aks3g/AiModelCar/README.md

# AiModelCar
A platform for AI Model Car.
