aks3g/AiModelCar/src/samples/with_odometer/readme.txt

■サンプル名：
with_odometer

■サンプル概要：
走行距離計から得られる情報を処理するプログラムです

■サンプル説明：
別添えの走行距離計から得られる走行距離情報もMicro SDカードに保存します。
表現形式は16進数のCSVです。

時刻情報,走行距離,制御値,加速度X,加速度Y,加速度Z,角速度X,角速度Y,角速度Z

の並びで保存されます。

■実行方法
1．プログラムを制御基板に書き込む
2．電源を入れる
3. SW1 を押して制御を開始する

■注意点：
Micro SDカードへの書込処理中に電源を落とさないようにしてください。
SW1を押下後、走行中はMicro SDカードへの書き込みが断続的に発生します。再度SW1を押下してモータの回転を止めると書込み動作が止まる為安全に電源を切る事が可能です。

■ETC.
Witten by Akasaka
