aks3g/AiModelCar/src/AtmelLibrarys/include/xmegaE5/uart_driver.h

/*
 * uart_driver.h
 *
 * Created: 2013/09/12 0:19:58
 *  Author: sazae7
 */ 


#ifndef UART_DRIVER_H_
#define UART_DRIVER_H_

/*---------------------------------------------------------------------------*/
/*---------------------------------------------------------------------------*/
#define UART_OK								(0)
#define UART_BUFFER_IS_NULL					(-1)
#define UART_INVALID_BAUDRATE				(-2)
#define UART_BUFFER_FULL					(-3)
#define UART_NOT_ENOUGH_BUFFER				(-4)
#define UART_BUFFER_EMPTY					(-5)
#define UART_INVALID_UART_TYPE				(-6)
#define UART_IS_ALREADY_INITIALIZED			(-7)

/*---------------------------------------------------------------------------*/
/*---------------------------------------------------------------------------*/
#define USART0_ON_PORTC_0					(0)
#define USART0_ON_PORTC_1					(1)
#define USART0_ON_PORTD_0					(2)
#define USART0_ON_PORTD_1					(3)

/*---------------------------------------------------------------------------*/
/*---------------------------------------------------------------------------*/
uint8_t initialize_uart(uint8_t usartType, uint32_t baudrate, uint32_t peripheralClock);

uint8_t uart_tx(uint8_t *dat, uint32_t len);
uint8_t uart_txNonBuffer(uint8_t *dat, uint32_t len);

uint8_t uart_rx(uint8_t *dat, uint32_t *len);
uint8_t uart_rx_n(uint8_t *dat, uint32_t rlen, uint32_t *len);
uint32_t uart_get_rxlen(void);
uint8_t uart_rxBlocking(uint8_t *dat, uint32_t rlen);

#endif /* UART_DRIVER_H_ */
