aks3g/AiModelCar/(commit log)

2015-04-12 Add New sample read_parameters_from_sdc
    [param.txt]
2015-04-12 Add New sample. Logging Sensor data to SDC.
2015-04-12 Add new sample. with_odometer.
2015-04-13 Fix Odometer issue. Add hex to dec script on /utils
    [with_odometer.cpp]
2015-04-16 Inclease UART BUFFER 32 byte to 128 byte.
2015-04-17 Move uart receiving process from main to timer interrupt handler.
2015-04-20 fix the timming issur. Add Interface for mapbased comtrol Reducee Write buffer for log data
    [uart_driver.cpp, with_odometer.cpp]
2015-05-17 Support attitude estimation logic. Add new sample for estimating attitude.
